gcronin/MazeLidarRobot/lidar_robot.brd

## EAGLE design lidar_robot.brd (2017-03-06)

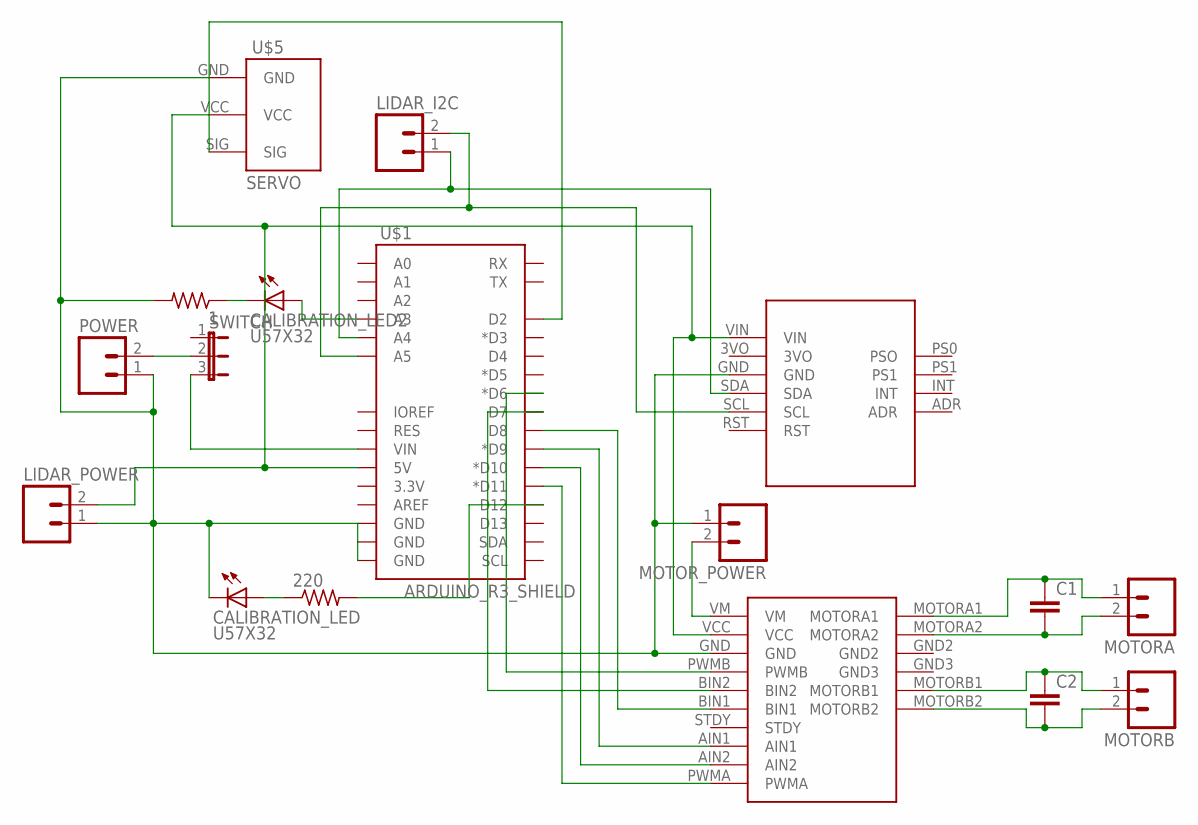
[picture p15: schematic lidar_robot.sch]

Parts:
1, 220: R-US_0207/10; 0207/10
C1, C2: C2.5/4; C2.5-4
CALIBRATION_LED, CALIBRATION_LED2: U57X32
LIDAR_I2C: M02LOCK; 1X02_LOCK
LIDAR_POWER: M02LOCK; 1X02_LOCK
MOTORA: M02LOCK; 1X02_LOCK
MOTORB: M02LOCK; 1X02_LOCK
MOTOR_POWER: M02LOCK; 1X02_LOCK
POWER: M02LOCK; 1X02_LOCK
SWITCH: JP2E; JP2
U$1: ARDUINO_R3_SHIELD; UNO_R3_SHIELD
U$2: BN0055
U$3: TB6612
U$5: SERVO

Connections:
unnamed: POWER.2, SWITCH.2
unnamed: SWITCH.3, U$1.VIN
unnamed: LIDAR_POWER.2, U$1.5V, U$2.VIN, U$3.VCC, U$5.VCC
unnamed: C2.1, MOTORB.1, U$3.MOTORB1
unnamed: C2.2, MOTORB.2, U$3.MOTORB2
unnamed: C1.1, MOTORA.1, U$3.MOTORA1
unnamed: C1.2, MOTORA.2, U$3.MOTORA2
unnamed: 1.2, CALIBRATION_LED.K (C), LIDAR_POWER.1, MOTOR_POWER.1, POWER.1, U$1.GND@0 (GND), U$1.GND@1 (GND), U$1.GND@2 (GND), U$2.GND, U$3.GND, U$5.GND
unnamed: U$1.D11 (*D11), U$3.PWMA
unnamed: U$1.D10 (*D10), U$3.AIN2
unnamed: LIDAR_I2C.1, U$1.A4, U$2.SDA
unnamed: LIDAR_I2C.2, U$1.A5, U$2.SCL
unnamed: U$1.D9 (*D9), U$3.AIN1
unnamed: U$1.D8, U$3.BIN1
unnamed: U$1.D2, U$5.SIG
unnamed: 220.2, U$1.D12
unnamed: U$1.D7, U$3.BIN2
unnamed: 220.1, CALIBRATION_LED.A
unnamed: U$1.D6 (*D6), U$3.PWMB
unnamed: 1.1, CALIBRATION_LED2.K (C)
unnamed: CALIBRATION_LED2.A, U$1.A3
unnamed: MOTOR_POWER.2, U$3.VM

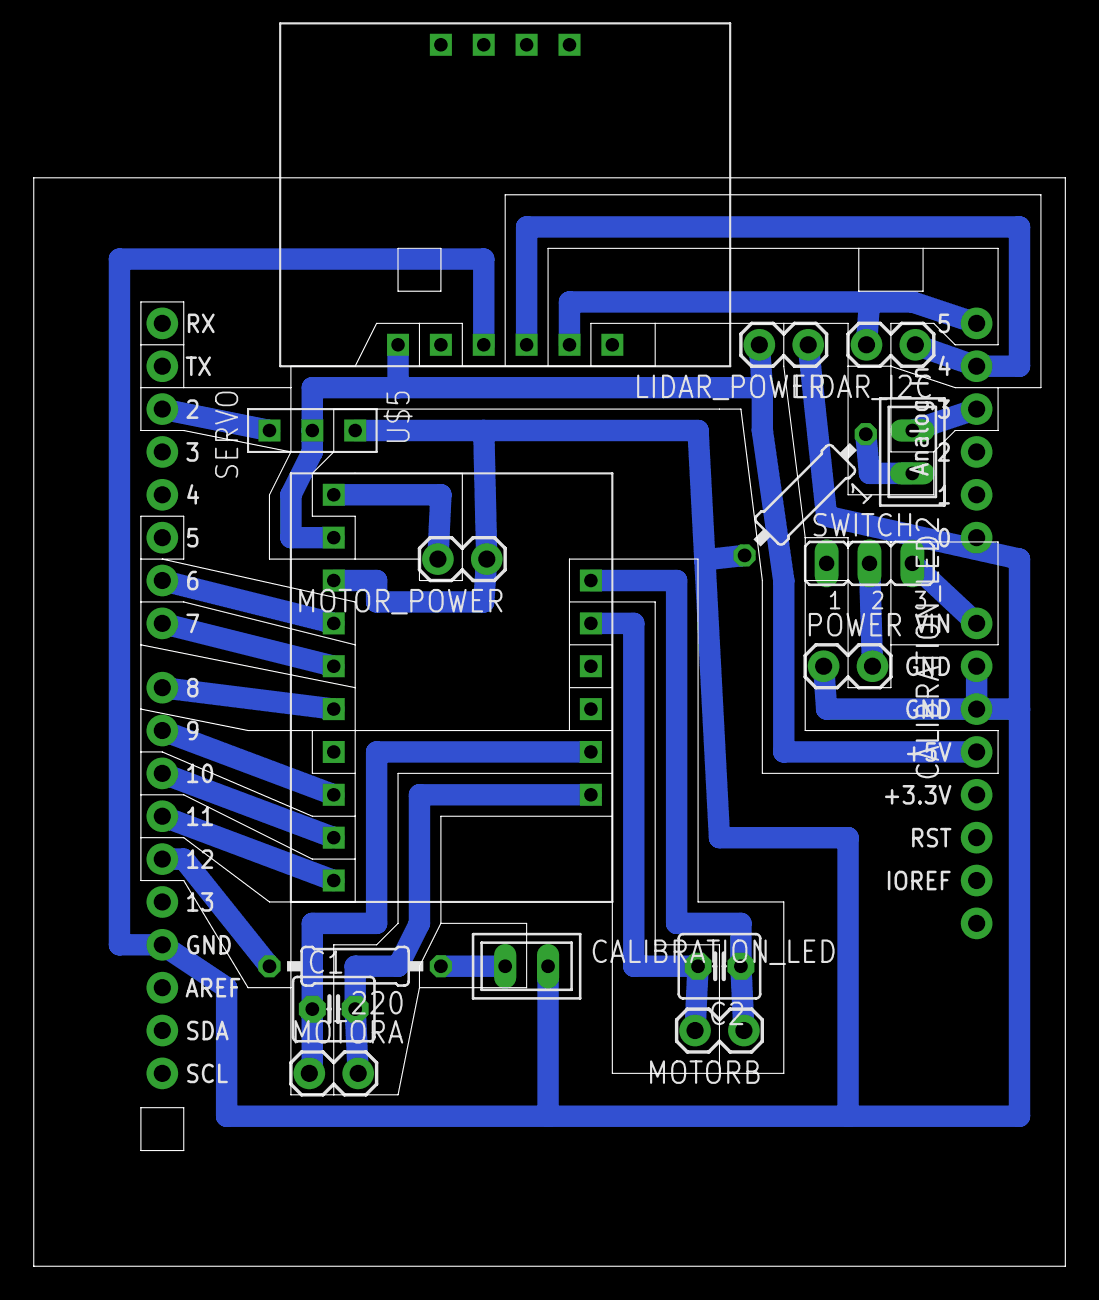
[picture p16: board lidar_robot.brd from above]

Board: 2 copper layers, 61.1 x 64.5 mm, 17 parts (0 on the bottom side), 22 nets.
