gcronin/MazeLidarRobot/LidarAndBN0055/LidarAndBN0055.ino

#include <I2C.h>
#include <Adafruit_TB6612.h>
#include <Servo.h>

Servo LidarTurret;  // create servo object to control a servo
int turretPosition = 0;
boolean spinningLeft = true;

// TB6612 H-Bridge Pins
#define AIN1 9
#define BIN1 8
#define AIN2 10
#define BIN2 7
#define PWMA 11
#define PWMB 6



// BN0055 specific registers
#define    BN0055_ADDRESS   0x28          // Default I2C Address of BN0055.
#define    CHIP_ID          0x00          // should contain the value 0xA0
#define    OPR_MODE         0x3D          // config, accelerometer only, fusion modes, etc.
#define    SYS_TRIGGER      0x3F          // used to reset, for external crystal oscillator
#define    POWER_MODE       0x3E          // Full power, standby, low power
#define    PAGE_ID          0x07          // there are 2 pages of registers, this tells which page you are on
#define    EULER_X_LSB      0X1A          // Euler Angle registers starting point
#define    TEMP_ADDR        0x34          // Temperature Register
byte value = -100;
double head, pitch, roll;  //Euler Angles
boolean calibrated = false;

// LIDAR specific registers
#define    LIDARLite_ADDRESS   0x62          // Default I2C Address of LIDAR-Lite.
#define    RegisterMeasure     0x00          // Register to write to initiate ranging.
#define    MeasureValue        0x04          // Value to initiate ranging.
#define    RegisterHighLowB    0x8f          // Register to get both High and Low bytes in 1 call.
int distance = -1;  // lidar distance reading

// these constants are used to allow you to make your motor configuration 
// line up with function names like forward.  Value can be 1 or -1
const int offsetA = 1;
const int offsetB = 1;

// Initializing motors. 
Motor motor1 = Motor(AIN1, AIN2, PWMA, offsetA);
Motor motor2 = Motor(BIN1, BIN2, PWMB, offsetB);

void setup() {
  boolean debug = false;
  Serial.begin(9600);
  pinMode(A3, OUTPUT);  // Power LED
  digitalWrite(A3, HIGH);
  pinMode(12, OUTPUT);  // LED to indicate calibration status
  
  I2c.begin(); // Opens & joins the irc bus as master
  I2c.timeOut(50); // Sets a timeout to ensure no locking up of sketch if I2C communication fails

  LidarTurret.attach(2);  // attaches the servo on pin 2 to the servo object
  
  if(BN0055setup(debug)) { Serial.println("Setup BN0055 Successful"); }
  if(BN0055useCrystal()) { Serial.println("BN0055 Using External Clock"); }
  while(readGyroCalibration() != 3) {}  // necessary to do this before the servo starts moving because the gyro needs to sit in peace to calibrate
}


void loop() {
  Serial.println("");
  BN0055ReadEuler();
  Serial.print("  ");
  BN0055getCalibration();
  Serial.print("  ");
  LidarTurret.write(turretPosition);
  spinningLeft ? turretPosition+=3 : turretPosition-=3;
  if(turretPosition > 180) spinningLeft = false;
  if(turretPosition < 0) spinningLeft = true;
  readLidar();
  delay(100);
}




int BN0055setup(boolean debug)
{
  i2cRead(BN0055_ADDRESS, CHIP_ID, 1, &value); // Read Chip ID, should be 0xA0
  if(value == 160) { if(debug) Serial.println("Found BN0055"); }
  else { return 0; }

  value = -100;
  i2cWrite(BN0055_ADDRESS, OPR_MODE, 0);  // Set operation mode to configure
  i2cRead(BN0055_ADDRESS, OPR_MODE, 1, &value);
  if(debug) Serial.print("OPR_MODE: ");
  if(debug) Serial.println(value);

  i2cWrite(BN0055_ADDRESS, SYS_TRIGGER, 0x20);   // reset the sensor
  while( value!=160) { i2cRead(BN0055_ADDRESS, CHIP_ID, 1, &value); }
  if(debug) Serial.println("Reset BN0055");


  value = -100;
  i2cWrite(BN0055_ADDRESS, POWER_MODE, 0); // Set power mode to normal
  i2cRead(BN0055_ADDRESS, POWER_MODE, 1, &value);
  if(debug) Serial.print("Power Mode: ");
  if(debug) Serial.println(value);
  
  value = -100;
  i2cWrite(BN0055_ADDRESS, PAGE_ID, 0); // Go to Page 0 of memory registers
  i2cRead(BN0055_ADDRESS, PAGE_ID, 1, &value);
  if(debug) Serial.print("Page ID: ");
  if(debug) Serial.println(value);
  
  i2cWrite(BN0055_ADDRESS, SYS_TRIGGER, 0); // no idea what this does
  value = -100;
  i2cWrite(BN0055_ADDRESS, OPR_MODE, 0X0C);  // set mode to Fusion NDOF
  i2cRead(BN0055_ADDRESS, OPR_MODE, 1, &value);
  if(debug) Serial.print("OPR_MODE: ");
  if(debug) Serial.println(value);
  return 1;
}

boolean BN0055useCrystal()
{
  i2cWrite(BN0055_ADDRESS, OPR_MODE, 0);  // Set operation mode to configure
  delay(30);
  delay(25);
  i2cWrite(BN0055_ADDRESS, PAGE_ID, 0); // Go to Page 0 of memory registers
  // Seemed like this "banging" was critical to getting it to work...
  i2cWrite(BN0055_ADDRESS, SYS_TRIGGER, 0x80);  //An External clock can be selected by setting bit CLK_SEL in the SYSTEM_TRIGGER register.) 0x80 = 10000000
  delay(50);
  i2cWrite(BN0055_ADDRESS, SYS_TRIGGER, 0x80);  //An External clock can be selected by setting bit CLK_SEL in the SYSTEM_TRIGGER register.) 0x80 = 10000000
  delay(50);
  i2cWrite(BN0055_ADDRESS, SYS_TRIGGER, 0x80);  //An External clock can be selected by setting bit CLK_SEL in the SYSTEM_TRIGGER register.) 0x80 = 10000000
  delay(50);
  i2cWrite(BN0055_ADDRESS, SYS_TRIGGER, 0x01); // triggers a self test
  delay(50);
  BN0055selfTest();
  i2cWrite(BN0055_ADDRESS, OPR_MODE, 0X0C);  // set mode the Fusion NDOF
  delay(30);
  delay(20);
  BN0055selfTest();
  return 1;
}


void BN0055selfTest()
{
  value = -100;
  i2cRead(BN0055_ADDRESS, 0X39, 1, &value);
  Serial.print("System Status: ");
  Serial.print(value);
  value = -100;
  i2cRead(BN0055_ADDRESS, 0X36, 1, &value);
  Serial.print("  Self Test Result: ");
  Serial.print(value);
  value = -100;
  i2cRead(BN0055_ADDRESS, 0X3A, 1, &value);
  Serial.print("  System Error: ");
  Serial.println(value);
}

void BN0055ReadEuler()
{
  uint8_t buffer[6];
  memset (buffer, 0, 6);  // set all buffer values to 0
  int16_t x, y, z;

  i2cRead(BN0055_ADDRESS, EULER_X_LSB, 6, &buffer[0]);
  x = ((int16_t)buffer[0]) | (((int16_t)buffer[1]) << 8);
  y = ((int16_t)buffer[2]) | (((int16_t)buffer[3]) << 8);
  z = ((int16_t)buffer[4]) | (((int16_t)buffer[5]) << 8);

   /* 1 degree = 16 LSB , (section 3.6.4)*/
  head  = ((double)x)/16.0;
  pitch = ((double)y)/16.0;
  roll = ((double)z)/16.0;

  Serial.print("X: ");
  Serial.print(head);
  Serial.print(" Y: ");
  Serial.print(pitch);
  Serial.print(" Z: ");
  Serial.print(roll);
}

void BN0055getCalibration()
{
  value = -100;
  byte reading;
  i2cRead(BN0055_ADDRESS, 0x35, 1, &value);
  reading = (value >> 6) & 0x03;
  Serial.print("    System: ");
  Serial.print(reading);
  if(reading == 3) digitalWrite(12, HIGH);
  else digitalWrite(12, LOW);
  reading = (value >> 4) & 0x03;
  Serial.print(" Gyro: ");
  Serial.print(reading);
  reading = (value >> 2) & 0x03;
  Serial.print(" Accel: ");
  Serial.print(reading);
  reading = value & 0x03;
  Serial.print(" Mag: ");
  Serial.print(reading);
}

byte readGyroCalibration()
{
  value = -100;
  byte reading;
  i2cRead(BN0055_ADDRESS, 0x35, 1, &value);
  reading = (value >> 4) & 0x03;
  return reading;
}

uint8_t i2cWrite(byte address, byte memoryRegister, byte value)
{
  uint8_t nackack = 100; // Setup variable to hold ACK/NACK responses
  while (nackack != 0){
    nackack = I2c.write(address, memoryRegister, value);
     delay(1); // Wait 1 ms to prevent overpolling 
  }
  delay(20);
  return nackack;
}

uint8_t i2cRead(byte address, byte memoryRegister, byte numBytes, char *dataBuffer )
{
  uint8_t nackack = 100; // Setup variable to hold ACK/NACK responses
  while (nackack != 0){
    nackack = I2c.read(address, memoryRegister, numBytes, (uint8_t*)dataBuffer);
     delay(1); // Wait 1 ms to prevent overpolling 
  }
  delay(20);
  return nackack;
}

void readLidar()
{  // Write 0x04 to register 0x00
  i2cWrite(LIDARLite_ADDRESS,RegisterMeasure, MeasureValue);
  
  byte distanceArray[2]; // array to store distance bytes from read function
  
  // Read 2byte distance from register 0x8f
  i2cRead(LIDARLite_ADDRESS,RegisterHighLowB, 2, distanceArray);
  
  distance = (distanceArray[0] << 8) + distanceArray[1];  // Shift high byte [0] 8 to the left and add low byte [1] to create 16-bit int
  Serial.print("Distance: ");
  Serial.print(distance);
}
