gcronin/MazeLidarRobot/(commit log)

2017-02-01 Working Test Programs for Lidar and BN0055
2017-02-02 Tested Integrated Lidar and BN0055 with I2C.h Library
2017-03-06 PCB Board added, pins updated
    [lidar_robot.brd, lidar_robot.sch]
